assumeengagetry/ironman_core/print_files/images/Part_1_117_FINAL.png

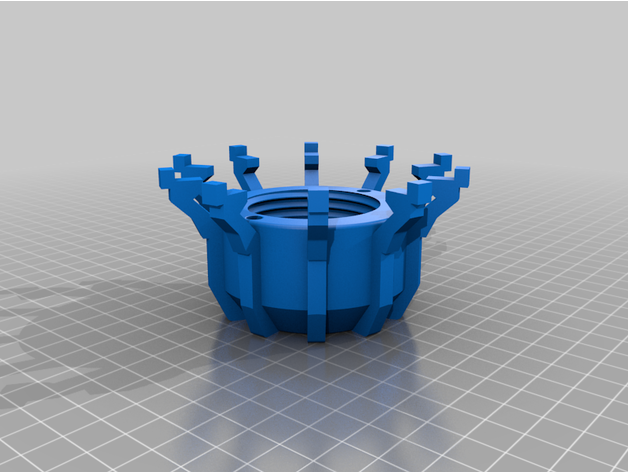
print_files/images/Part_1_117_FINAL.png
