assumeengagetry/ironman_core/print_files/images/Part_10_117_FINAL.png

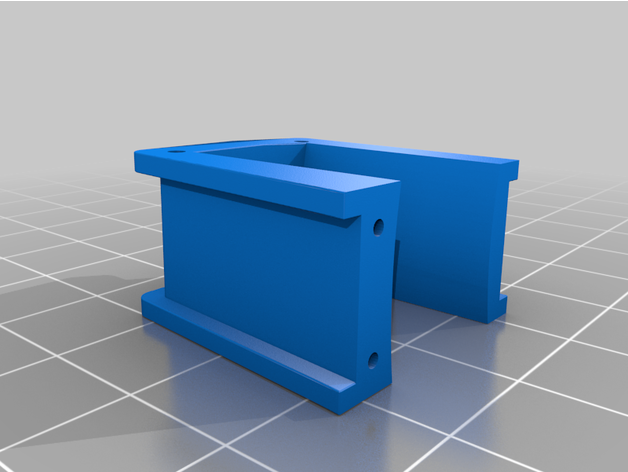
print_files/images/Part_10_117_FINAL.png
