assumeengagetry/ironman_core/README.md

# 钢铁侠核心物联网项目

## 简介

本项目是一个物联网项目，旨在模仿钢铁侠的核心反应堆。它不仅能够显示时间，还能模拟脉冲发射的效果。项目包括3D打印部分、组装指南以及Arduino烧录和程序调试步骤。

## 功能

- **时间显示**：实时显示当前时间。
- **脉冲发射**：模拟钢铁侠核心的脉冲发射效果。
- **物联网集成**：通过Arduino进行控制和调试。

## 硬件需求

- Arduino开发板
- 3D打印材料（用于打印核心外壳）
- 显示屏（用于时间显示）
- 其他电子元件（如LED灯、电阻、电容等）

## 软件需求

- Arduino IDE
- 3D打印软件（如PrusaSlicer、Cura等）

## 项目步骤

### 1. Pre-Study

在开始之前，请确保阅读以下文档和资源，以便更好地理解项目的工作原理和需求。
pre_study

先导知识，开始制作本核心前，需掌握的技能

———————————————————————

src
1.IRON_MAN烧录程序
2.须打印文件
3.制作视频

### 2. 3D打印部分

- 下载3D模型文件printfiles
- 使用3D打印软件进行切片，并打印核心外壳。

### 3. 组装

- 根据referernce，将打印好的外壳与电子元件组装在一起。

### 4. Arduino烧录与程序调试

- 下载并安装Arduino IDE（1.8左右 ，我是1.8.16）。
- 将提供的代码上传到Arduino开发板。

## 代码

项目代码位于`src`目录下，主要文件包括：

- `main.`：主程序文件，负责时间显示和脉冲发射的逻辑。

## 贡献

我们欢迎任何形式的贡献！如果你有任何改进建议或想要添加新功能，请提交Pull Request。

## 许可证

本项目遵循[MIT许可证](https://opensource.org/licenses/MIT)。请在分发或使用本项目时遵守许可证规定。
