assumeengagetry/ironman_core/1.Aruidno软件下载-安装-测试教程.pdf

2023/9/25 21:58 | 二、Arduino软件下载-安装-测试教程

blog.csdn.net /weixin_44940488/article/details/121419727

# 二、 Arduino软件下载-安装-测试教程

# （一）下载Arduino IDE

## 官方下载地址： Software | Arduino

## Arduino IDE老版本下载链接 ：https://www.arduino.cc/en/Main/OldSoftwareReleases\#previous

# 进入到arduino页面后，找到下图显示部分，然后下载arduino软件安装压缩包。

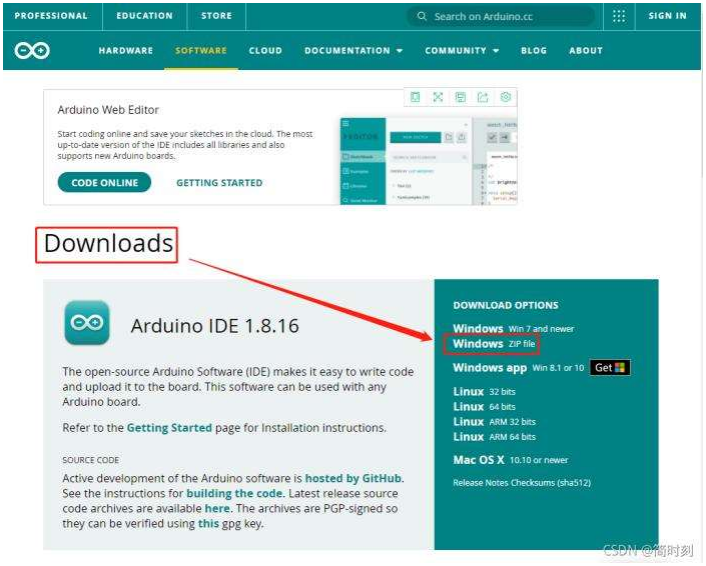
[picture p41: figure]

## Windows用户，点击下载Windows(ZIPfile)，如果Mac ，Linux用户则选择相应的系统。 下载完成后，解压

# 文件，把解压后的Arduino文件夹放到自己安装软件的位置，便于自己之后查找。

# （二）安装Arduino软件

# 1. 打开解压的Arduino文件夹，双击运行arduino程序即可。

chrome-extension://nhiebejbpolmpkikgbijamagibifhjib/data/reader/index.html?id=310807597&url=https%3A%2F%2Fblog.csdn.net%2Fweixin_44… 1/8

# （新版本的arduino程序可以直接双加运行）

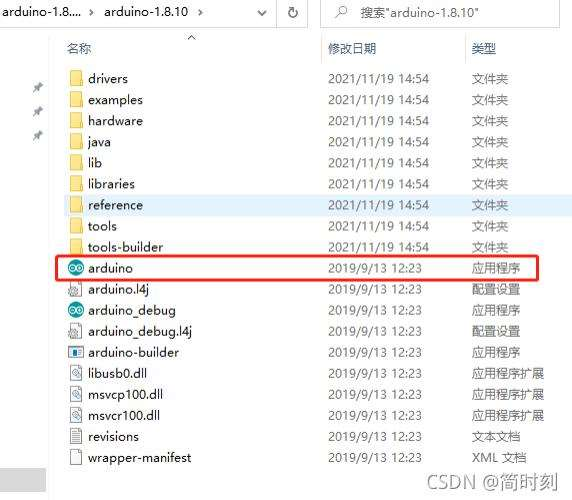
[picture p42: figure]

# 2. 选择开发板：选择“工具”中的“开发板选项” ，选择我们接入的开发板型号。

chrome-extension://nhiebejbpolmpkikgbijamagibifhjib/data/reader/index.html?id=310807597&url=https%3A%2F%2Fblog.csdn.net%2Fweixin_44… 2/8

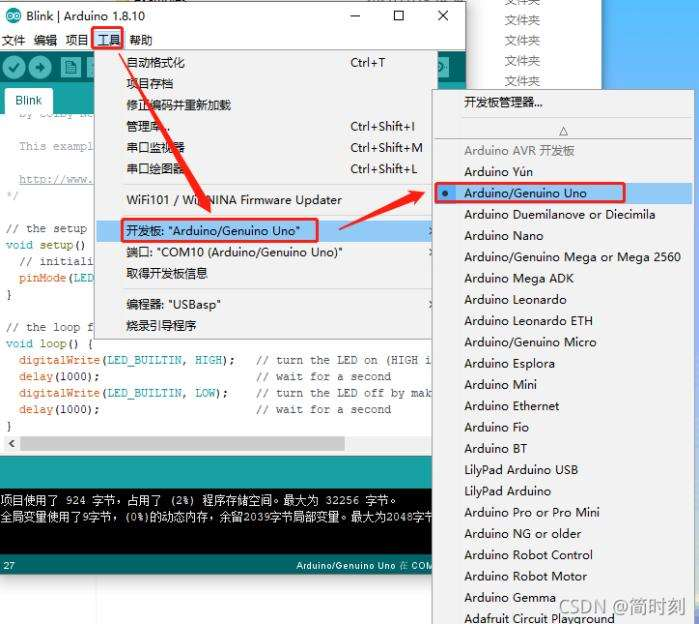
[picture p43: figure]

# 3. 选择端口：插入开发板，选择“工具”中的“端口” ，选择端口中显示的端口。

chrome-extension://nhiebejbpolmpkikgbijamagibifhjib/data/reader/index.html?id=310807597&url=https%3A%2F%2Fblog.csdn.net%2Fweixin_44… 3/8

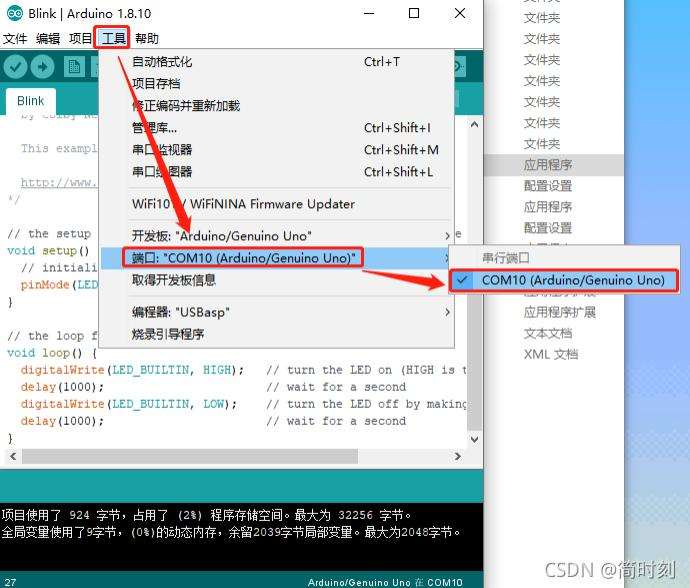
[picture p44: figure]

# 问题：有时候我们的“端口”呈现灰色，无法选择端口。

chrome-extension://nhiebejbpolmpkikgbijamagibifhjib/data/reader/index.html?id=310807597&url=https%3A%2F%2Fblog.csdn.net%2Fweixin_44… 4/8

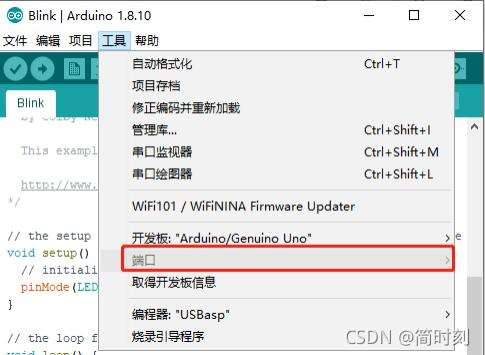
[picture p45: figure]

# 解决方法：

# 1. 电脑上选择换一个端口进行插入，看看会不会有端口出来。 2. 端口接触不良，拔出来再重新插入即可。

# （三）测试程序（Blink程序）

## 1. 选择“文件”——“示例”——“01.Basics”——“ Blink”程序

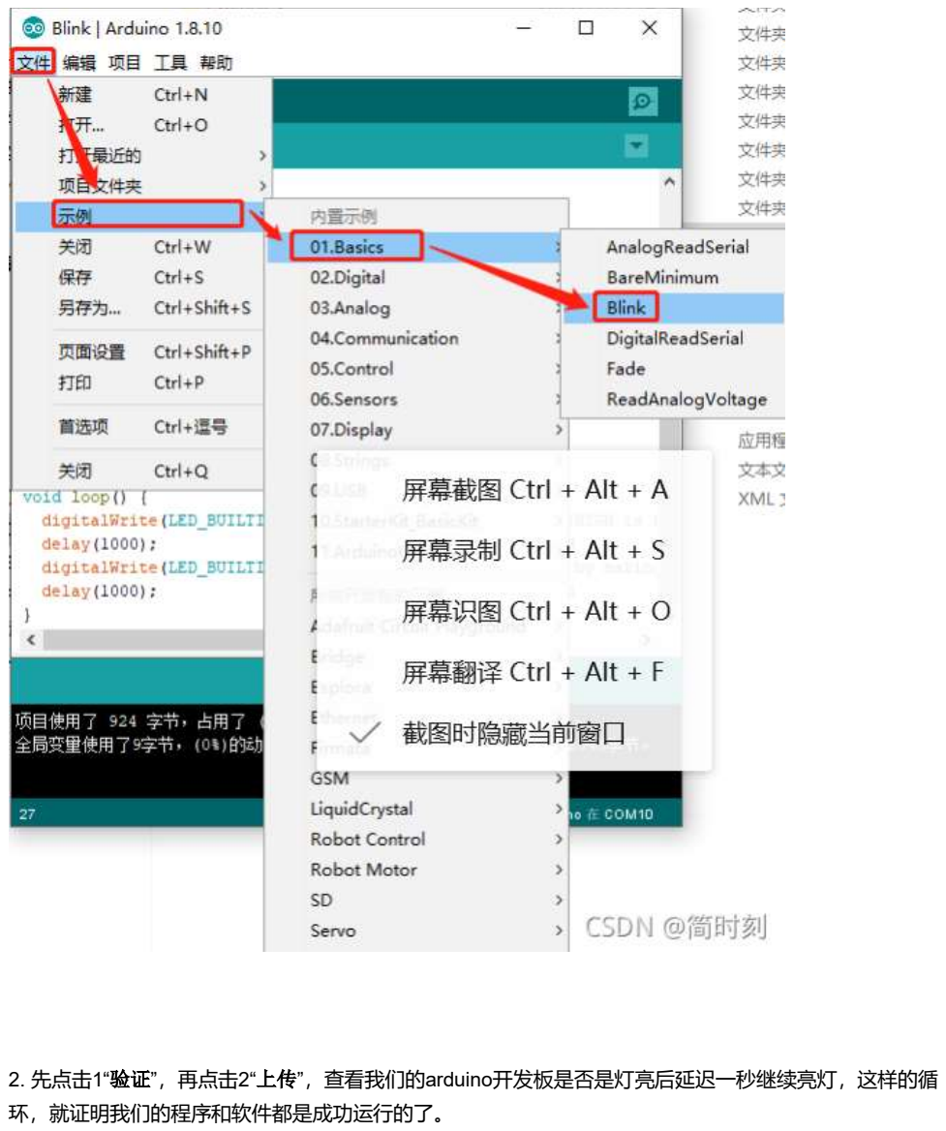
[picture p46: page 6]

# 2. 先点击1“验证”，再点击2“上传”，查看我们的arduino开发板是否是灯亮后延迟一秒继续亮灯，这样的循 环，就证明我们的程序和软件都是成功运行的了。

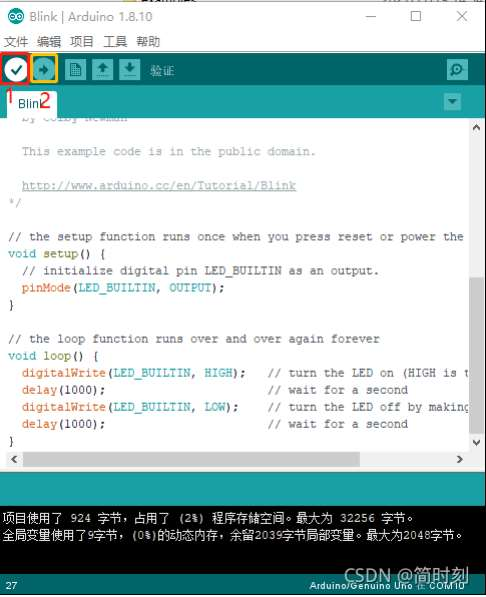
[picture p47: figure]

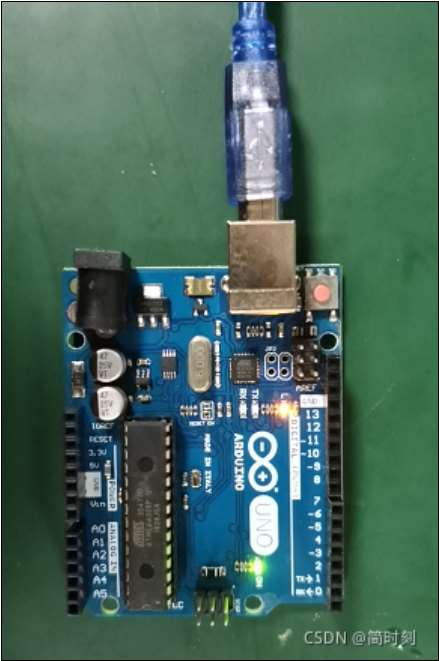
[picture p48: figure]

chrome-extension://nhiebejbpolmpkikgbijamagibifhjib/data/reader/index.html?id=310807597&url=https%3A%2F%2Fblog.csdn.net%2Fweixin_44… 5/8
