assumeengagetry/ironman_core/print_files/【TRANSPARENT】Part_2_117_FINAL.stl

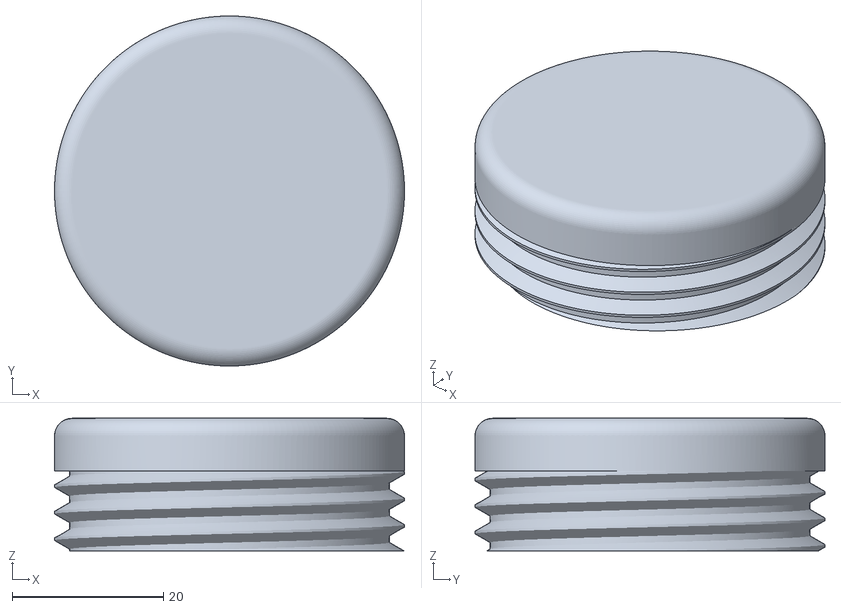
[picture p49: CAD file, 2024-11-01]
print_files/【TRANSPARENT】Part_2_117_FINAL.stl
46.3 x 46.3 x 17.6
