assumeengagetry/ironman_core/print_files/【TRANSPARENT】Part_4_117_FINAL.stl

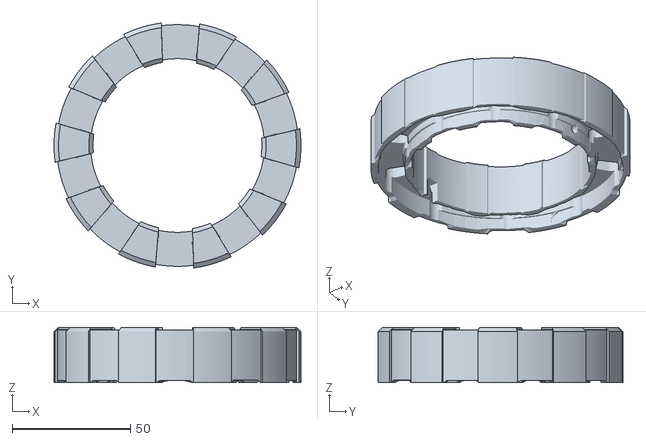
[picture p50: CAD file, 2024-11-01]
print_files/【TRANSPARENT】Part_4_117_FINAL.stl
104.4 x 103.6 x 23.4
