assumeengagetry/ironman_core/print_files/【BLACK】Part_3_117_FINAL.stl

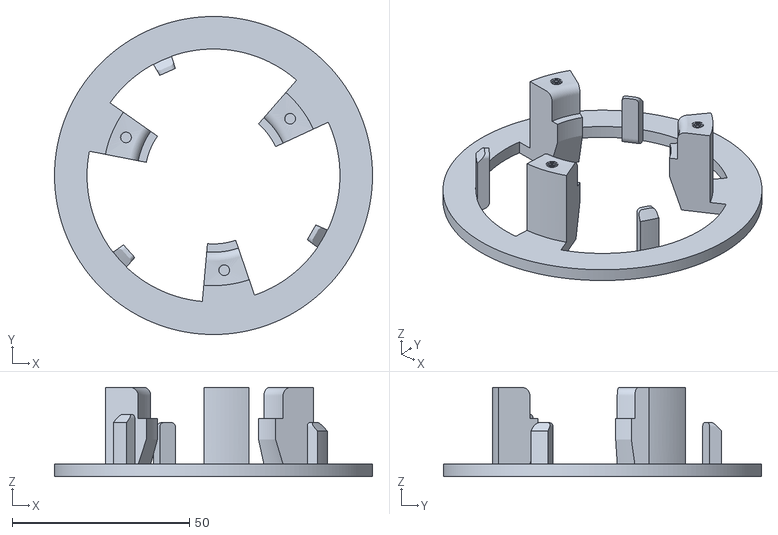
[picture p51: CAD file, 2024-11-01]
print_files/【BLACK】Part_3_117_FINAL.stl
89.7 x 89.7 x 25.2
