assumeengagetry/ironman_core/print_files/【BLACK】Part_8_117_FINAL.stl

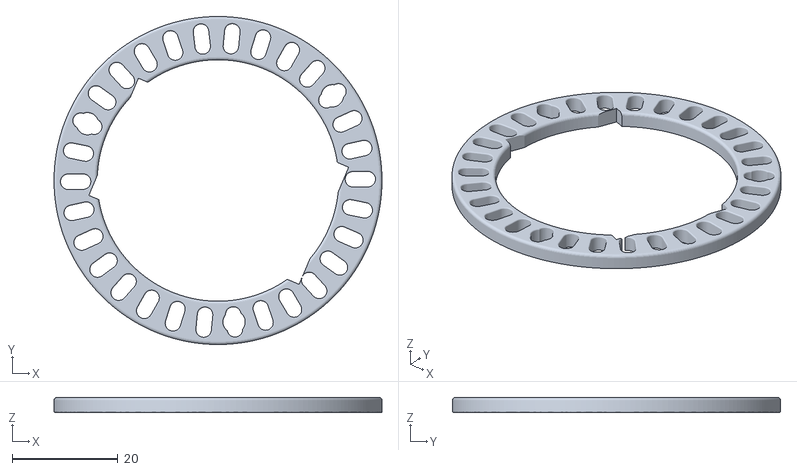
[picture p52: CAD file, 2024-11-01]
print_files/【BLACK】Part_8_117_FINAL.stl
62.0 x 62.0 x 2.92
