assumeengagetry/ironman_core/print_files/【BLACK】Part_7_117_FINAL_2.stl

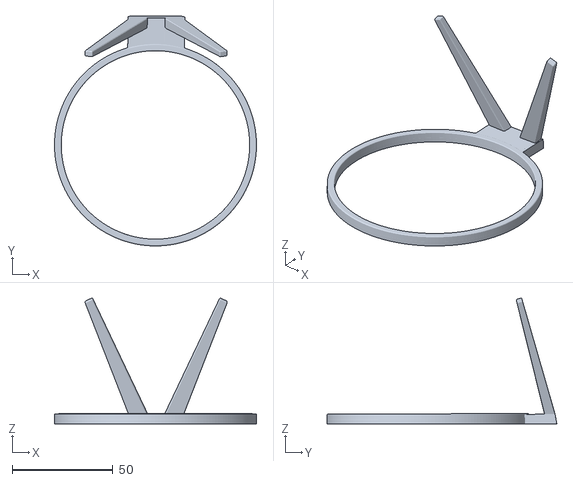
[picture p53: CAD file, 2024-11-01]
print_files/【BLACK】Part_7_117_FINAL_2.stl
100.2 x 114.0 x 62.4
