assumeengagetry/ironman_core/print_files/【BLACK】Part_6_FINAL.stl

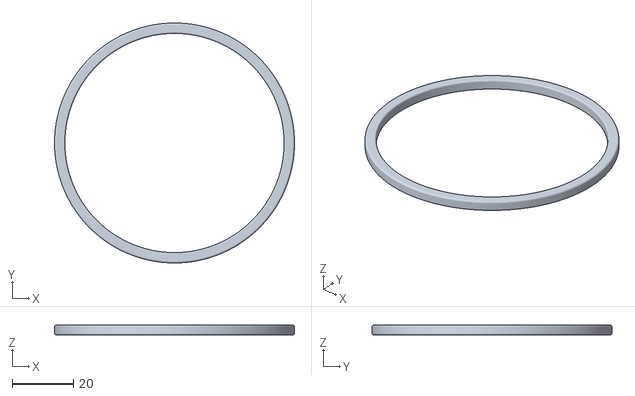
[picture p54: CAD file, 2024-11-01]
print_files/【BLACK】Part_6_FINAL.stl
78.1 x 78.1 x 3.28
