assumeengagetry/ironman_core/print_files/【BLACK】Part_10_117_FINAL.stl

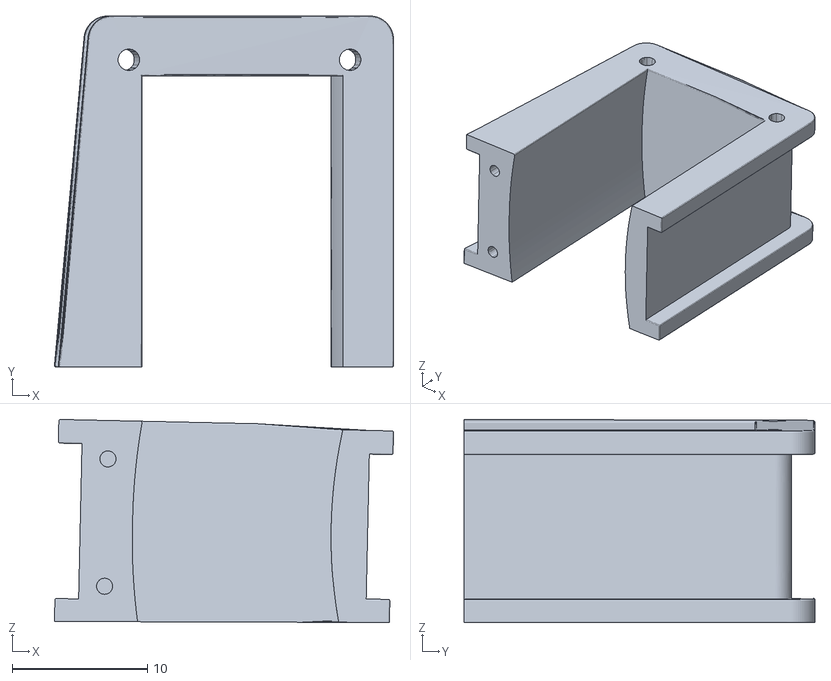
[picture p55: CAD file, 2024-11-01]
print_files/【BLACK】Part_10_117_FINAL.stl
25.1 x 26.0 x 15.0
