assumeengagetry/ironman_core/print_files/【BLACK】Part_1_117_FINAL.stl

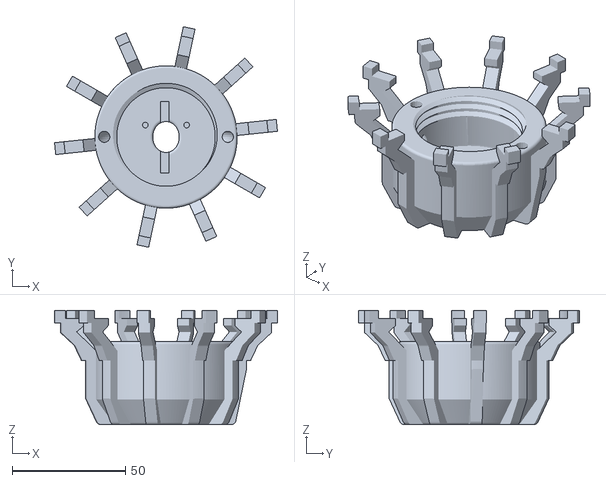
[picture p56: CAD file, 2024-11-01]
print_files/【BLACK】Part_1_117_FINAL.stl
98.4 x 97.4 x 50.5
