assumeengagetry/ironman_core/print_files/【BLACK】Part_9_117_FINAL_2.STL

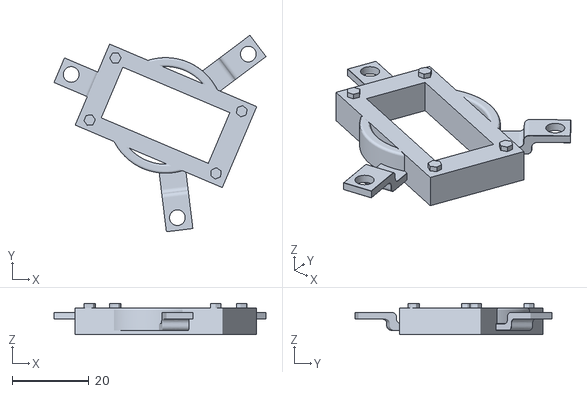
[picture p57: CAD file, 2024-11-01]
print_files/【BLACK】Part_9_117_FINAL_2.STL
55.4 x 51.4 x 8.12
