assumeengagetry/ironman_core/print_files/【BLACK】Part_5_FINAL.stl

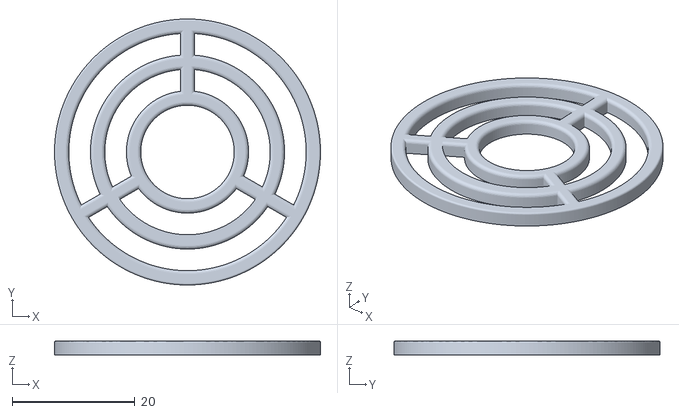
[picture p58: CAD file, 2024-11-01]
print_files/【BLACK】Part_5_FINAL.stl
43.3 x 43.3 x 2.34
