assumeengagetry/ironman_core/print_files/README.txt

打印须知：
Part2和Part4需要使用【透明】材料打印

其他的Part需要使用【黑色】材料打印

Part10需要打印十次
————————————————————————
文件格式：
打印颜色 + part + 名字

————————————————————————

images文件

接线图X3（esp32 to显示屏，led灯，led环）
3D打印渲染图X10

————————————————————————

建议：
1.嘉立创EDA下单打印，光敏树脂精度高。（选择便宜的光敏材料打印，需要注意【打印的材料颜色】）（打印成本100-120元）
2.闲鱼PLA下单打印。市场价格0.2元/g（左右）。（需要注意【打印的材料颜色】）（本打印件 253g * 0.2 = 50.6元） 

————————————
一般网上下单，发送的是STL格式文件，记得告诉厂家打印需求：【指定颜色】、【part10 x 10次】
