assumeengagetry/ironman_core/print_files/images/MiniD1_+_Display_0000000.jpg

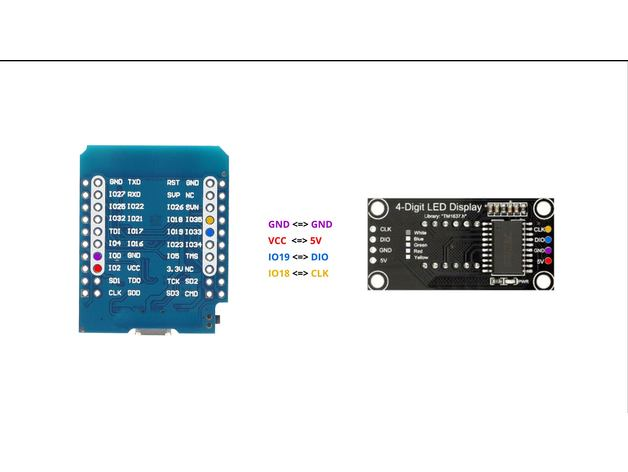
print_files/images/MiniD1_+_Display_0000000.jpg
