assumeengagetry/ironman_core/print_files/images/Part_5_FINAL.png

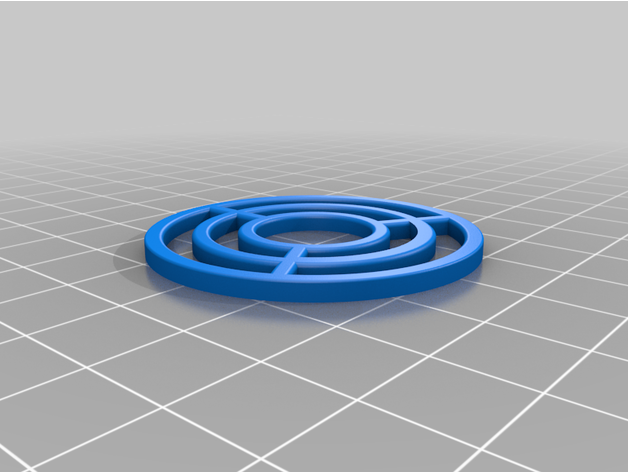
print_files/images/Part_5_FINAL.png
