assumeengagetry/ironman_core/print_files/images/Part_6_FINAL.png

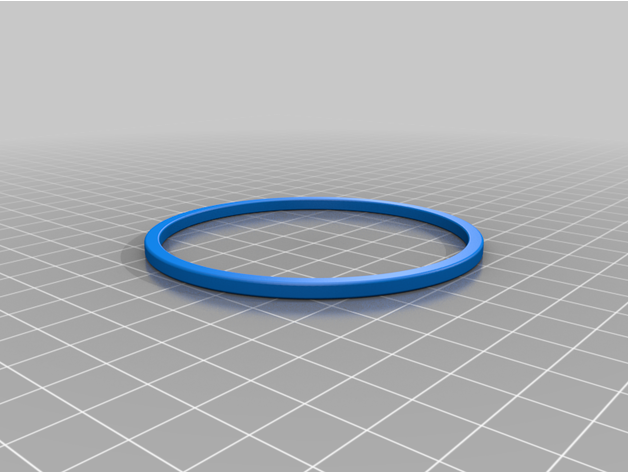
print_files/images/Part_6_FINAL.png
