assumeengagetry/ironman_core/print_files/images/Part_7_117_FINAL_2.png

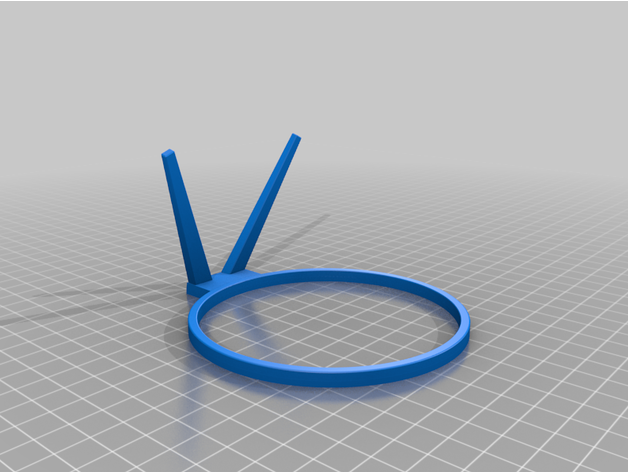
print_files/images/Part_7_117_FINAL_2.png
