assumeengagetry/ironman_core/print_files/images/Part_8_117_FINAL.png

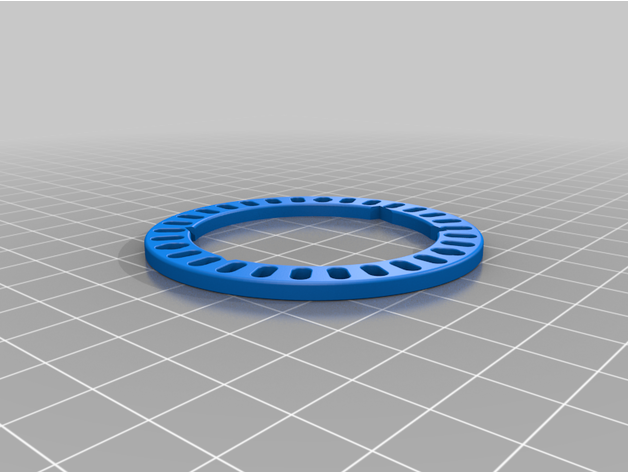
print_files/images/Part_8_117_FINAL.png
