assumeengagetry/ironman_core/(commit log)

2024-11-01 Add files via upload
    打印须知：
    Part2和Part4需要使用【透明】材料打印
    其他的Part需要使用【黑色】材料打印
    Part10需要打印十次
    ————————————————————————
    文件格式：
    打印颜色 + part + 名字
    ————————————————————————
    images文件
    接线图X3（esp32 to显示屏，led灯，led环）
    3D打印渲染图X10
    ————————————————————————
    建议：
    1.嘉立创EDA下单打印，光敏树脂精度高。（选择便宜的光敏材料打印，需要注意【打印的材料颜色】）（打印成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
    [【BLACK】Part_10_117_FINAL.stl, 【BLACK】Part_1_117_FINAL.stl, 【BLACK】Part_3_117_FINAL.stl, 【BLACK】Part_5_FINAL.stl, 【BLACK】Part_6_FINAL.stl, 【BLACK】Part_7_117_FINAL_2.stl, 【BLACK】Part_8_117_FINAL.stl, 【BLACK】Part_9_117_FINAL_2.STL]
2024-11-01 这是代码，希望你看得懂
